GiovaSanta/PulseOxyemeter-LotiBloxy/LoTiBloxy.kicad_pcb

## KiCad design LoTiBloxy.kicad_pcb (2025-09-07)

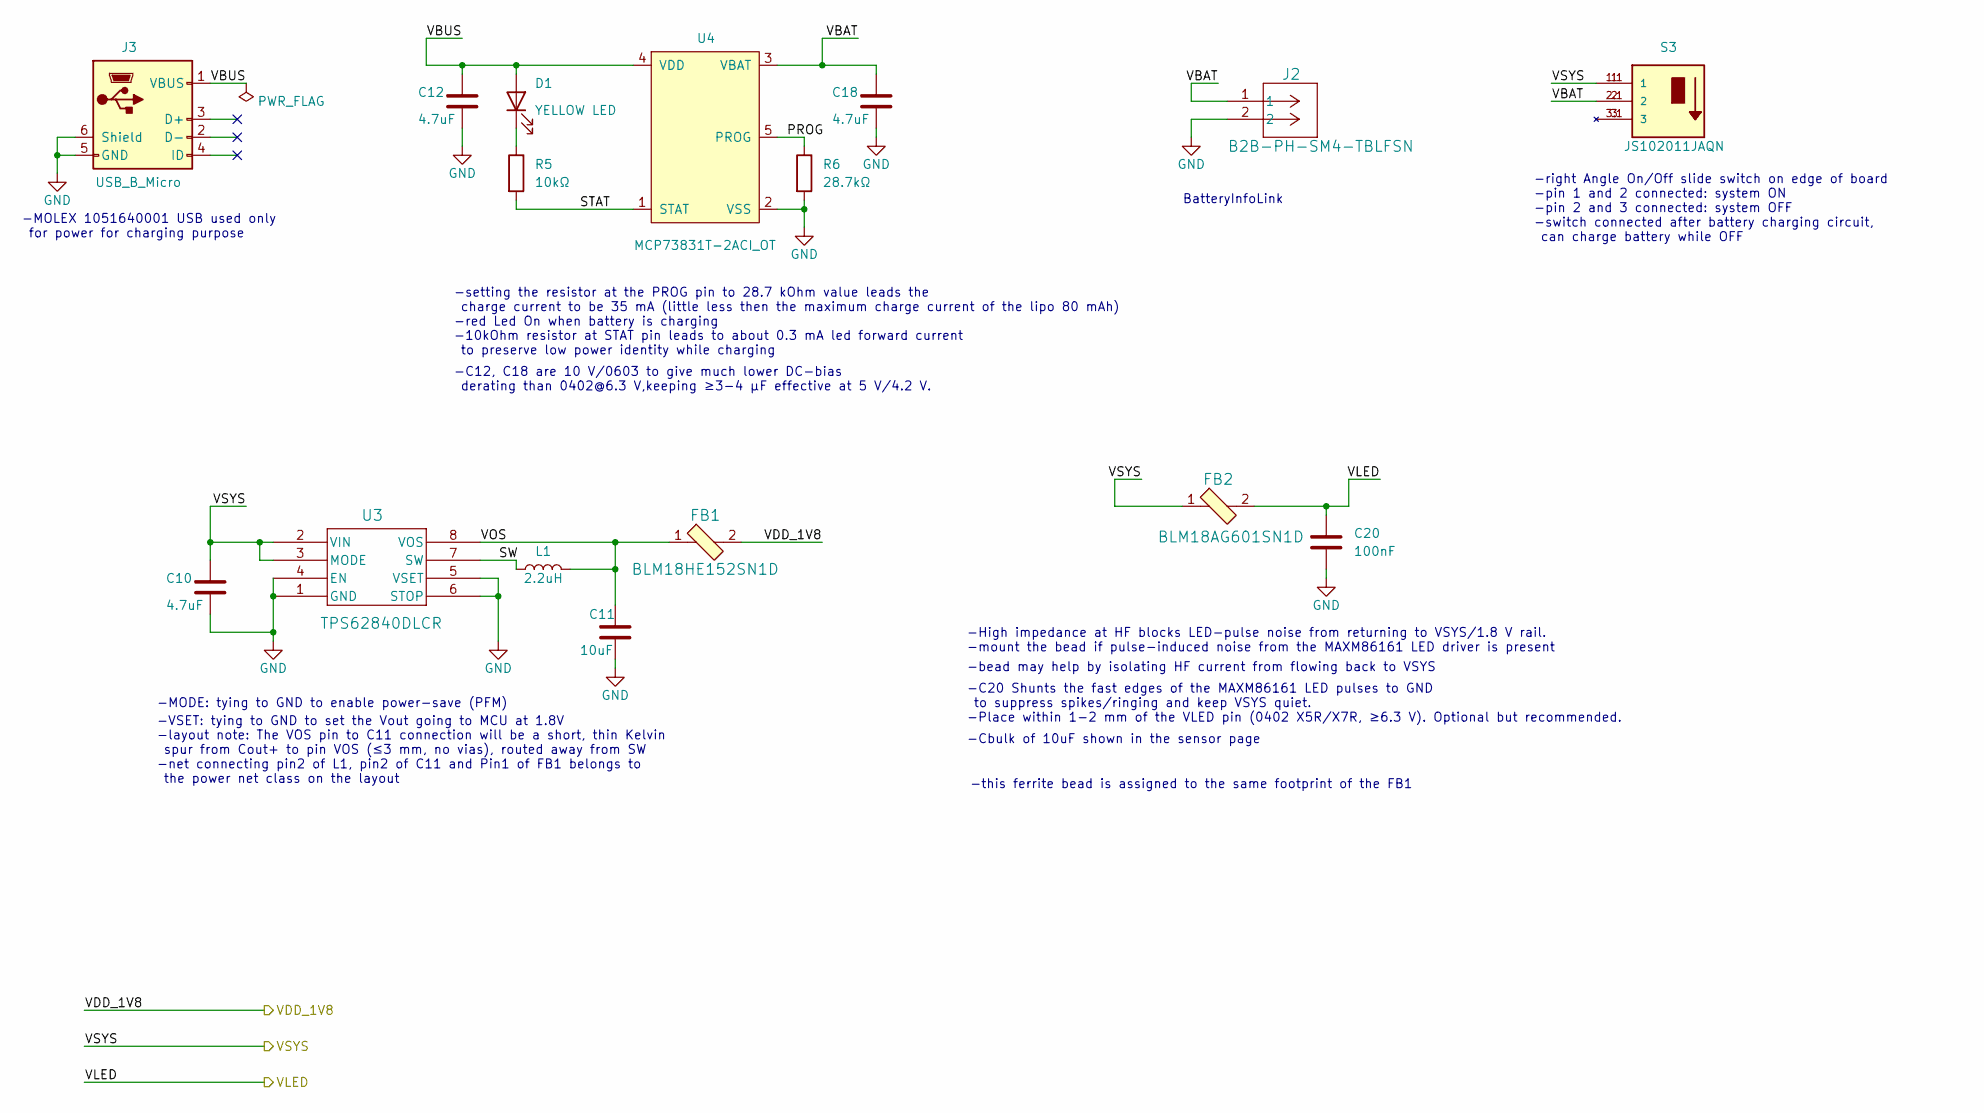
[picture p15: schematic PowerSection.kicad_sch]

Parts:
C10, C12, C18: 4.7uF; C_0603_1608Metric; MPN CC0603KRX5R6BB475
C11: 10uF; C_0603_1608Metric; MPN GRM188R60J106ME47D
C20: 100nF; C_0402_1005Metric; MPN GRM155R70J104KA01D
D1: YELLOW LED; LED_SML-P12UT_ROM; MPN SML-P11YTT86
FB1: BLM18HE152SN1D; IND_BLM18_0603_MUR; MPN BLM18HE152SN1D; Digi-Key_PN 490-5216-1-ND
FB2: BLM18AG601SN1D; IND_BLM18_0603_MUR; MPN BLM18AG601SN1D; Digi-Key_PN 490-1014-1-ND
J2: B2B-PH-SM4-TBLFSN; CONN_S2B-PH-SM4-TB_JST; MPN B2B-PH-SM4-TB
J3: USB_B_Micro; CON00906_5_MOL; MPN 1051640001
L1: 2.2uH; L_0805_2012M_Murata-LQM21PN; MPN LQM21PN2R2NGCD
R5: 10kΩ; R_0402_1005Metric; MPN RMCF0402FT10K0
R6: 28.7kΩ; R_0402_1005Metric; MPN RMCF0402FT28K7
S3: JS102011JAQN; SW_JS102011JAQN; PARTREV 29 June 16
U3: TPS62840DLCR; VSON8_2P1X1P6_TEX; MPN TPS62840DLCR
U4: MCP73831T-2ACI_OT; mcp73831T_SOT-23-5; MPN MCP73831T-2ACI/OT; Digi-Key_PN MCP73831T-2ACI/OTCT-ND

Connections:
/PowerSection/PROG: R6.1, U4.5 (PROG)
/PowerSection/STAT: R5.2, U4.1 (STAT)
/PowerSection/SW: L1.1, U3.7 (SW)
/PowerSection/VBAT: C18.1, J2.1, S3.2, S3.2.1 (2), U4.3 (VBAT)
/PowerSection/VBUS: C12.1, D1.2 (A), J3.1 (VBUS), U4.4 (VDD)
/PowerSection/VOS: C11.1, FB1.1, L1.2, U3.8 (VOS)
/VDD_1V8: FB1.2; also elsewhere on the board
/VLED: C20.1, FB2.2; also elsewhere on the board
/VSYS: C10.1, FB2.1, S3.1, S3.1.1 (1), U3.2 (VIN), U3.3 (MODE); also elsewhere on the board
GND: C10.2, C11.2, C12.2, C18.2, C20.2, J2.2, J3.5 (GND), J3.6 (Shield), R6.2, U3.1 (GND), U3.4 (EN), U3.5 (VSET), U3.6 (STOP), U4.2 (VSS); also elsewhere on the board
unnamed: D1.1 (K), R5.1

Notes on the sheet:
-VSET: tying to GND to set the Vout going to MCU at 1.8V
-setting the resistor at the PROG pin to 28.7 kOhm value leads the charge current to be 35 mA (little less then the maximum charge current of the lipo 80 mAh) -red Led On when battery is charging
BatteryInfoLink
-C20 Shunts the fast edges of the MAXM86161 LED pulses to GND to suppress spikes/ringing and keep VSYS quiet. -Place within 1-2 mm of the VLED pin (0402 X5R/X7R, ≥6.3 V). Optional but recommended.
-Cbulk of 10uF shown in the sensor page
-10kOhm resistor at STAT pin leads to about 0.3 mA led forward current to preserve low power identity while charging
-C12, C18 are 10 V/0603 to give much lower DC-bias derating than 0402@6.3 V,keeping ≥3-4 µF effective at 5 V/4.2 V.
-right Angle On/Off slide switch on edge of board -pin 1 and 2 connected: system ON -pin 2 and 3 connected: system OFF -switch connected after battery charging circuit, can charge battery while OFF
-MOLEX 1051640001 USB used only for power for charging purpose
-this ferrite bead is assigned to the same footprint of the FB1
-bead may help by isolating HF current from flowing back to VSYS
-MODE: tying to GND to enable power-save (PFM)
-layout note: The VOS pin to C11 connection will be a short, thin Kelvin spur from Cout+ to pin VOS (≤3 mm, no vias), routed away from SW -net connecting pin2 of L1, pin2 of C11 and Pin1 of FB1 belongs to the power net class on the layout
-High impedance at HF blocks LED-pulse noise from returning to VSYS/1.8 V rail. -mount the bead if pulse-induced noise from the MAXM86161 LED driver is present

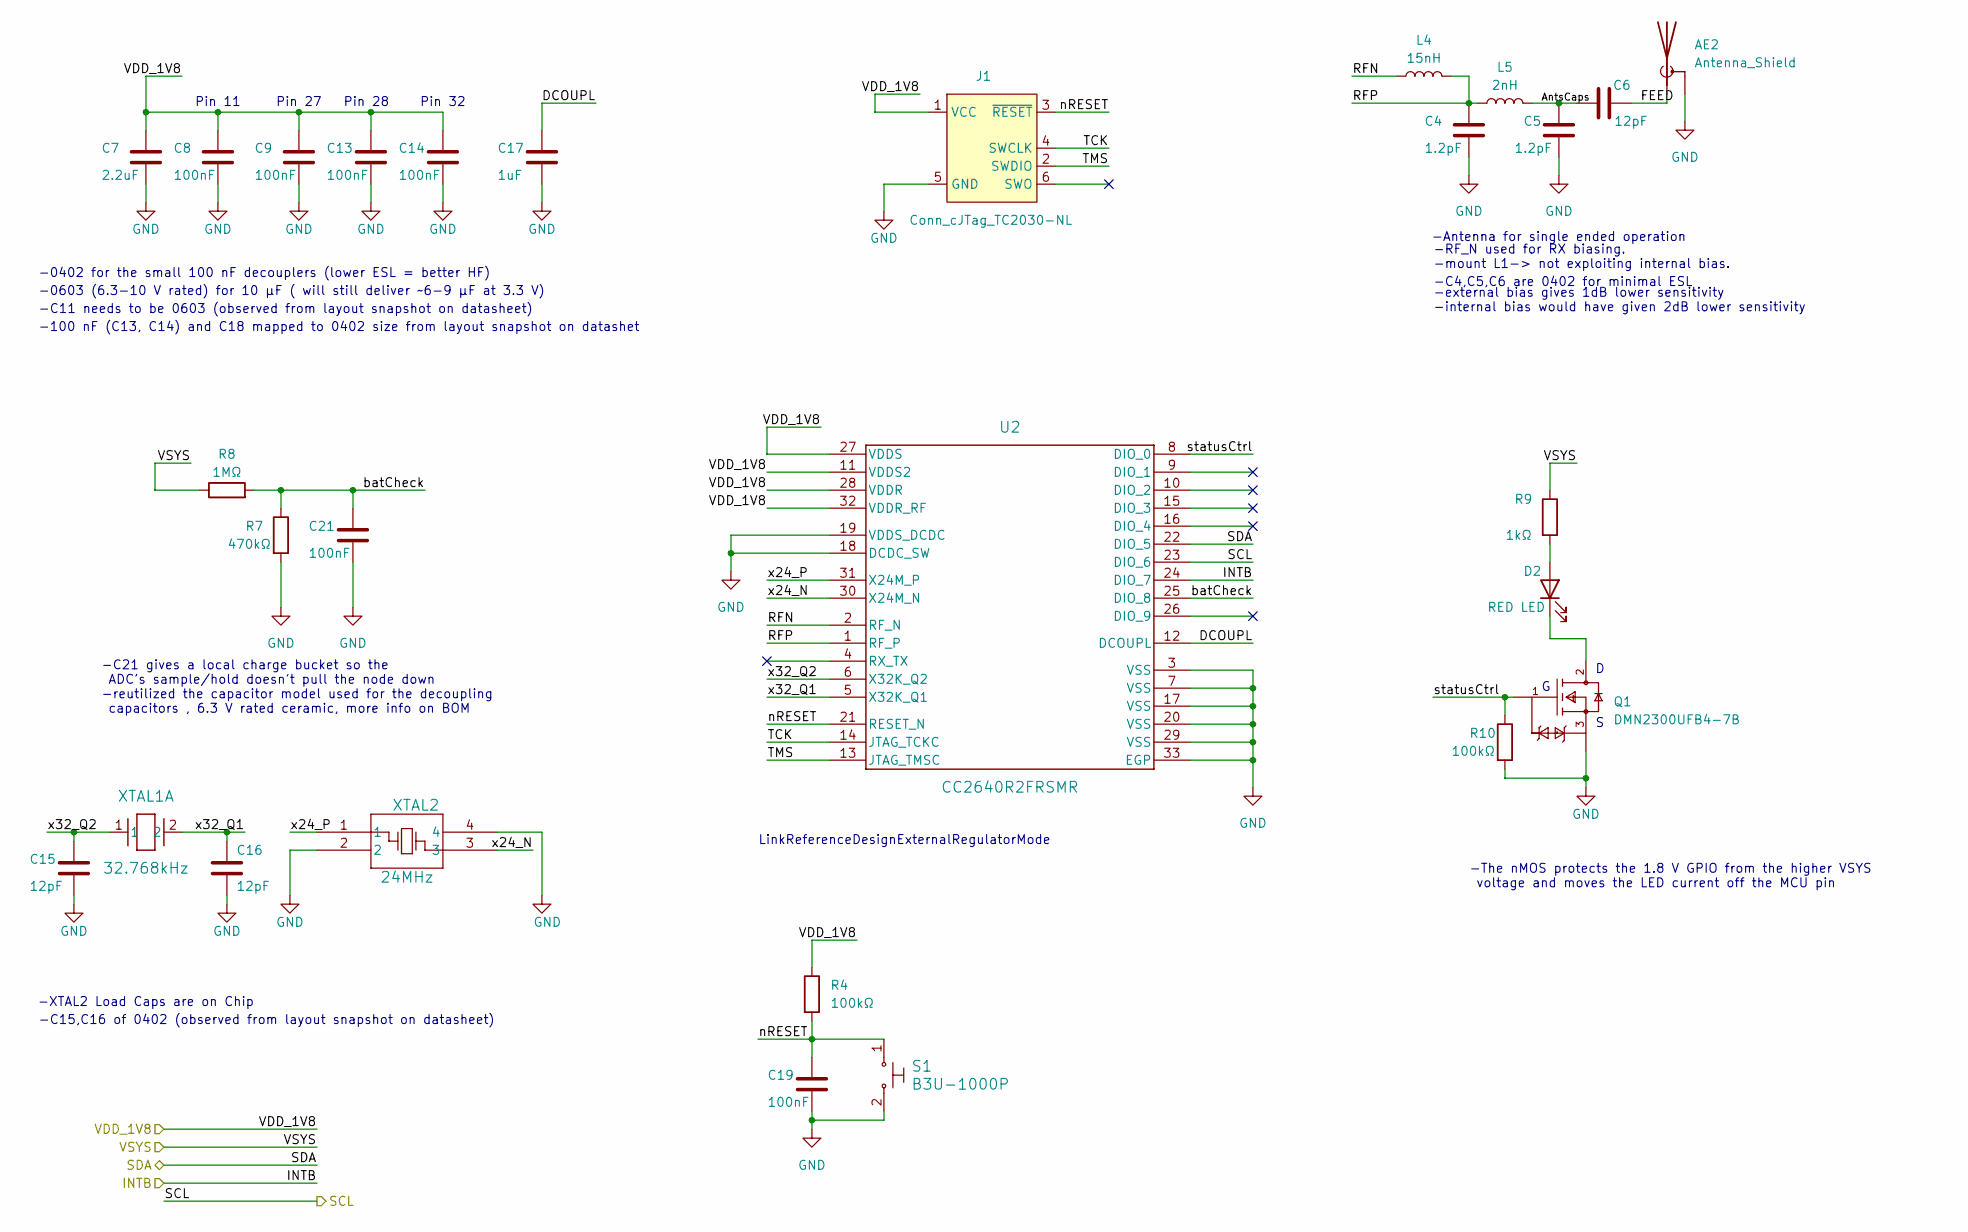
[picture p16: schematic MCU.kicad_sch]

Parts:
AE2: Antenna_Shield; Texas_SWRA117D_2.4GHz_Left
C4, C5: 1.2pF; C_0402_1005Metric; MPN GRM1555C1H1R2BA01D
C6, C15, C16: 12pF; C_0402_1005Metric; MPN QSCF500Q120J1GV001T
C7: 2.2uF; C_0402_1005Metric; MPN GRM155R60J225KE95D
C8, C9, C13, C14, C19, C21: 100nF; C_0402_1005Metric; MPN GRM155R70J104KA01D
C17: 1uF; C_0402_1005Metric; MPN CC0402KRX5R6BB105
D2: RED LED; LED_SML-P12UT_ROM; MPN SML-P11VTT86
J1: Conn_cJTag_TC2030-NL; Tag-Connect_TC2030-IDC-NL_2x03_P1.27mm_Vertical
L4: 15nH; L_0402_1005M_Murata-LQG15HS; MPN LQG15HS15NJ02D
L5: 2nH; L_0402_1005M_Murata-LQG15HS; MPN LQG15HS2N0S02D
Q1: DMN2300UFB4-7B; Diodes_Inc.-X2-DFN1006-3-04_2017-0-MFG; mouser part number 522-DMN2300UFB4-7B; digikey description MOSFET N-CH 20V 1.3A 3DFN
R4, R10: 100kΩ; R_0402_1005Metric; MPN RMCF0402FT100K
R7: 470kΩ; R_0402_1005Metric; MPN RMCF0402FT470K
R8: 1MΩ; R_0402_1005Metric; MPN CRGCQ0402F1M0
R9: 1kΩ; R_0402_1005Metric; MPN RMCF0402FT1K00
S1: B3U-1000P; Switch_Tactile_SMD_B3U-1000P; MPN B3U-1000P; Digi-Key_PN SW1020CT-ND
U2: CC2640R2FRSMR; MCU_CC2640R2F_RSM0032B; MPN CC2640R2FRSM
XTAL1: 32.768kHz; XTAL_SC-20S_EPS; MPN SC20S-12.5PF20PPM
XTAL2: 24MHz; ECS-160-8-36-RHN-TR_ECS; MPN ECS-240-8-36-RWN-TR

Connections:
/INTB: U2.24 (DIO_7); also elsewhere on the board
/MCU/AntsCaps: C5.1, C6.1, L5.2
/MCU/DCOUPL: C17.1, U2.12 (DCOUPL)
/MCU/FEED: AE2.1 (A), C6.2
/MCU/RFN: L4.1, U2.2 (RF_N)
/MCU/RFP: C4.1, L4.2, L5.1, U2.1 (RF_P)
/MCU/TCK: J1.4 (SWCLK), U2.14 (JTAG_TCKC)
/MCU/TMS: J1.2 (SWDIO), U2.13 (JTAG_TMSC)
/MCU/batCheck: C21.1, R7.1, R8.2, U2.25 (DIO_8)
/MCU/nRESET: C19.1, J1.3 (~RESET), R4.2, S1.1, U2.21 (RESET_N)
/MCU/statusCtrl: Q1.1 (G), R10.1, U2.8 (DIO_0)
/MCU/x24_N: U2.30 (X24M_N), XTAL2.3
/MCU/x24_P: U2.31 (X24M_P), XTAL2.1
/MCU/x32_Q1: C16.1, U2.5 (X32K_Q1), XTAL1.2
/MCU/x32_Q2: C15.1, U2.6 (X32K_Q2), XTAL1.1
/SCL: U2.23 (DIO_6); also elsewhere on the board
/SDA: U2.22 (DIO_5); also elsewhere on the board
/VDD_1V8: C7.1, C8.1, C9.1, C13.1, C14.1, J1.1 (VCC), R4.1, U2.11 (VDDS2), U2.27 (VDDS), U2.28 (VDDR), U2.32 (VDDR_RF); also elsewhere on the board
/VSYS: R8.1, R9.1; also elsewhere on the board
GND: AE2.2 (Shield), C4.2, C5.2, C7.2, C8.2, C9.2, C13.2, C14.2, C15.2, C16.2, C17.2, C19.2, C21.2, J1.5 (GND), Q1.3 (S), R7.2, R10.2, S1.2, U2.3 (VSS), U2.7 (VSS), U2.17 (VSS), U2.18 (DCDC_SW), U2.19 (VDDS_DCDC), U2.20 (VSS), U2.29 (VSS), U2.33 (EGP), XTAL2.2, XTAL2.4; also elsewhere on the board
unnamed: D2.2 (A), R9.2
unnamed: D2.1 (K), Q1.2 (D)

Notes on the sheet:
-RF_N used for RX biasing. -mount L1-> not exploiting internal bias.
Pin 28
-C11 needs to be 0603 (observed from layout snapshot on datasheet)
LinkReferenceDesignExternalRegulatorMode
-100 nF (C13, C14) and C18 mapped to 0402 size from layout snapshot on datashet
-external bias gives 1dB lower sensitivity -internal bias would have given 2dB lower sensitivity
-C4,C5,C6 are 0402 for minimal ESL
Pin 32
-The nMOS protects the 1.8 V GPIO from the higher VSYS voltage and moves the LED current off the MCU pin
Pin 27
-XTAL2 Load Caps are on Chip
-C21 gives a local charge bucket so the ADC's sample/hold doesn't pull the node down -reutilized the capacitor model used for the decoupling capacitors , 6.3 V rated ceramic, more info on BOM
-0402 for the small 100 nF decouplers (lower ESL = better HF)
Pin 11
-C15,C16 of 0402 (observed from layout snapshot on datasheet)
-Antenna for single ended operation
-0603 (6.3-10 V rated) for 10 µF ( will still deliver ~6-9 µF at 3.3 V)

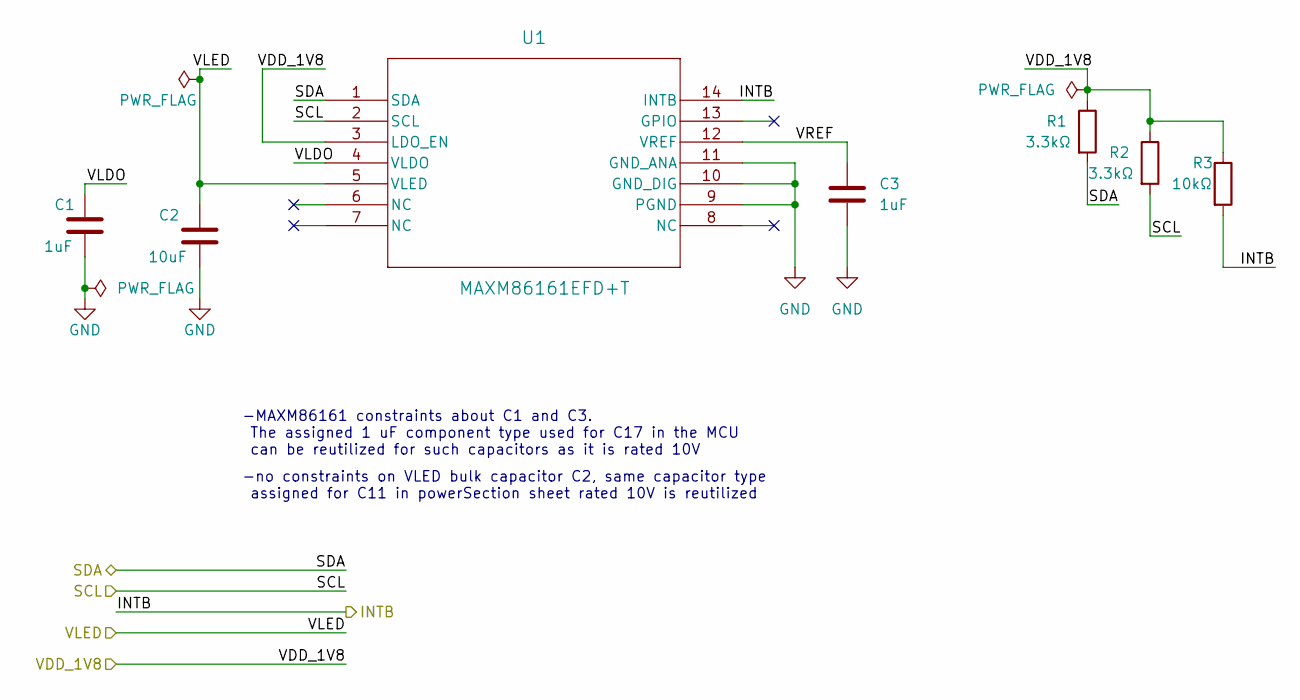
[picture p17: schematic sensor.kicad_sch]

Parts:
C1, C3: 1uF; C_0402_1005Metric; MPN CC0402KRX5R6BB105
C2: 10uF; C_0603_1608Metric; MPN GRM188R60J106ME47D
R1, R2: 3.3kΩ; R_0402_1005Metric; MPN RMCF0402FT3K30
R3: 10kΩ; R_0402_1005Metric; MPN RMCF0402FT10K0
U1: MAXM86161EFD+T; ul_MAXM86161EFD-T; MPN MAXM86161EFD+T

Connections:
/INTB: R3.2, U1.14 (INTB); also elsewhere on the board
/SCL: R2.2, U1.2 (SCL); also elsewhere on the board
/SDA: R1.2, U1.1 (SDA); also elsewhere on the board
/VDD_1V8: R1.1, R2.1, R3.1, U1.3 (LDO_EN); also elsewhere on the board
/VLED: C2.1, U1.5 (VLED); also elsewhere on the board
/sensor/VLDO: C1.1, U1.4 (VLDO)
/sensor/VREF: C3.1, U1.12 (VREF)
GND: C1.2, C2.2, C3.2, U1.9 (PGND), U1.10 (GND_DIG), U1.11 (GND_ANA); also elsewhere on the board

Notes on the sheet:
-MAXM86161 constraints about C1 and C3. The assigned 1 uF component type used for C17 in the MCU can be reutilized for such capacitors as it is rated 10V
-no constraints on VLED bulk capacitor C2, same capacitor type assigned for C11 in powerSection sheet rated 10V is reutilized

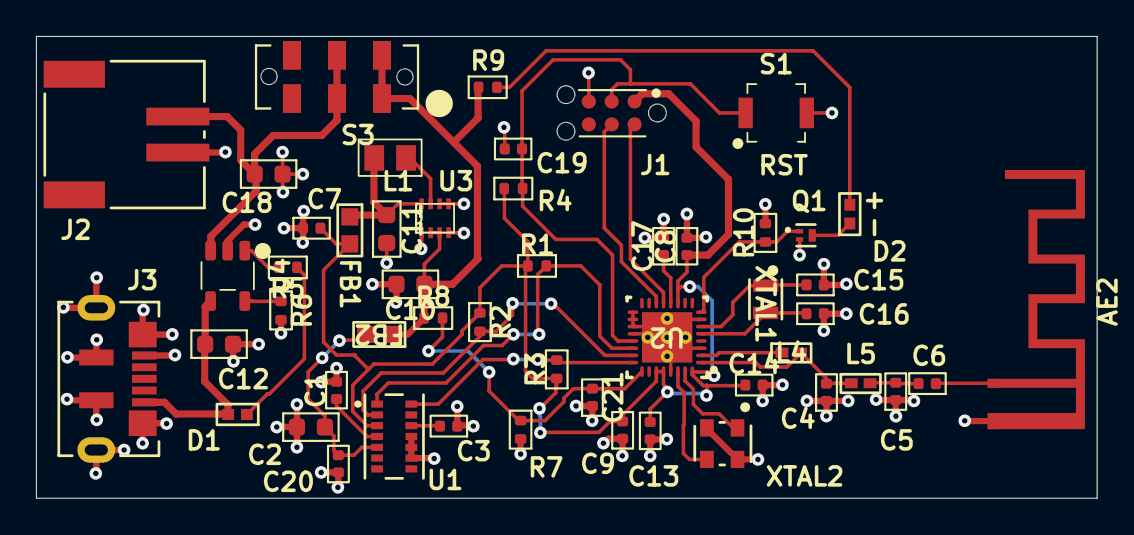
[picture p18: board LoTiBloxy.kicad_pcb from above]

Board: 2 copper layers, 58.9 x 25.7 mm, 51 parts (0 on the bottom side), 32 nets.
