GiovaSanta/PulseOxyemeter-LotiBloxy/ManufacturerReport.pdf

We thank you for your price request and are pleased to present you the following quotation today | 7 September 2025

Administrative details

Your references

Offer nr. | B4957934
Service | PCB proto | Purchase reference | ‐
Board name | GerbersLoTiBloxy‐Ver7 | Project reference | ‐
| | Article number | ‐

Invoicing & delivery details

Invoice to: polito Giovanni Santangelo Italy 39 3276834987 s308882@studenti.polito.it | | Delivered to: polito Giovanni Santangelo Italy 39 3276834987 s308882@studenti.polito.it

# PCB

PCB Visualizer

PCB images

Top view : | Bottom view:

Buildup & Mechanical plan

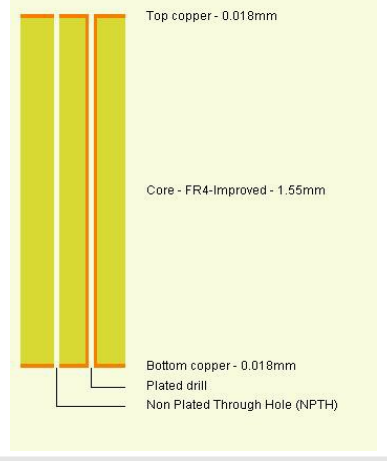
[picture p19: figure]

Technology & options

Board definition

Number of layers | 2 | Delivery format | No
PCB width ﴾X﴿ | 58.93 mm | PCB height ﴾Y﴿ | 25.65 mm
eC‐registration compatible | No

Board definition

Top soldermask | Green | Bottom soldermask | Green
Top legend | White | Bottom legend | White
Surface finish | Che Ni/Au
| selective
Bare board testing | Yes

Board technology

Pattern class | 4 | Drill class | Drill C
Outer layer trackwidth ﴾OL‐TW﴿ | 0.200 mm | Hole density | <1000/dm2
Outer layer isolation distance ﴾OL‐TT‐TP‐PP﴿ | 0.200 mm | Holes <= may be reduced | 0.45 mm
Outer layer annular ring ﴾OAR﴿ | 0.150 mm

# QUOTATION

EUROCIRCUITS N.V.
Antwerpsesteenweg 66
2800 MECHELEN
Belgium
www.eurocircuits.com | Phone:+3215281630 E‐mail:euro@eurocircuits.com

Material definition

Board thickness | 1.55 mm | Board buildup | Standard buildup
Base material | FR4IMP | Material Tg | 145‐150°C
Outer layer copper foil | 18µm﴾End‐
| Cu
| +/‐35µm﴿ | Inner layer copper foil | 0
Extra PTH runs | 0 | Extra press cycles | 0
Reversed buildup | No | Inner layer core thickness | Standard

Advanced options

Milling | No | Peelable mask | No
Edge connector gold surface mm² | 0 | Edge connector bevelling | No
Copper up to board edge | No | Plated holes on the board edge | No
Carbon contacts | No | Viafill | No
Top heatsink paste | No | Bottom heatsink paste | No
Specific tolerances | No | Specific marking | No
Press‐fit holes | No | Depth routing | No
Round‐edge plating | No | Chamfered mechanical holes | No

Pricing

Printed circuits

Basket nr. | Delivery term | PCB quantity | Unit price | Transport price | Transport mode | Total price | VAT | Gross
B4957934 | 3 Working
| days | 1 | 52.56 EUR | 3.68 EUR | Express | 56.24 EUR | 22.00 % | 68.61 EUR

Validity conditions, lead time and payment terms

This offer is valid for 30 days from the date on the document. It has been prepared in accordance with our terms of sales, available on our website, and accepted by you upon registration of your Eurocircuits online customer account.
The prices and delivery terms listed are based on the information and/or data provided by you. If these change, the final price and terms of delivery may also change.

When ordering this offer, we will check:

Whether any newly provided information and/or data still corresponds to those that formed the basis of this quotation. Your credit status with Eurocircuits.
Compliance with our Terms of Sales (http://www.eurocircuits.com/terms-of-sales/)

Before accepting or rejecting your order.

The lead time of your order starts to run the next working day after receipt of your order, provided it has been accepted by us.
The payment term of our invoices is 30 days invoice date unless there are circumstances or arrangements ﴾credit status or specific agreements﴿ that change this to payment before fulfilment ﴾pre‐payment﴿.

# QUOTATION

EUROCIRCUITS N.V.
Antwerpsesteenweg 66
2800 MECHELEN
Belgium
www.eurocircuits.com | Phone:+3215281630 E‐mail:euro@eurocircuits.com
