GiovaSanta/PulseOxyemeter-LotiBloxy/(commit log)

2025-08-22 finalized a first version of the sensor sheet, need still to perform ERC check on the proposed sensor sheet. started creating the MCU hierechical sheet
    [LoTiBloxy.kicad_pcb, LoTiBloxy.kicad_sch, MCU.kicad_sch, sensor.kicad_sch]
2025-08-27 first finished schematic version of the MCU as well as sensor. starting out with schematic of the power related components
    [LoTiBloxy.kicad_sch, MCU.kicad_sch, PowerSection.kicad_sch, sensor.kicad_sch]
2025-08-30 done with first version PowerSection of LoTiBloxy plus MCU plus sensor sheets. still have to add meaningfull comments to all schematic components. still have to make sure every symbol is associated t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
    [LoTiBloxy.kicad_sch, MCU.kicad_sch, PowerSection.kicad_sch, sensor.kicad_sch]
2025-09-01 finished associating each component of each sheet of schematic to relative footprint. filled in first version field for BOM. Provided organized hierechical level directories for all the datasheets fo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
    [MCU.kicad_sch, PowerSection.kicad_sch, sensor.kicad_sch]
2025-09-02 ERC step done. most important errors and warnings resolved (the ones about unspecified pins etcetra). with the occasion have done also the checking of the symbols of each component to make sure of co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
    [MCU.kicad_sch, PowerSection.kicad_sch, sensor.kicad_sch]
2025-09-07 finished layout, associated 3d models for the components, drc ran with no errors. fixed foorprints and their individaul pad dimensions (solder mask layer related, copper layer related and paste mask 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
    [LoTiBloxy-B_Cu.gbl, LoTiBloxy-B_Mask.gbs, LoTiBloxy-B_Paste.gbp, LoTiBloxy-B_Silkscreen.gbo, LoTiBloxy-Edge_Cuts.gm1, LoTiBloxy-F_Cu.gtl, LoTiBloxy-F_Fab.gbr, LoTiBloxy-F_Mask.gts]
